GarageTech/jerkmaster/docs/build-notes.md

<p align="center">
  JerkMaster
</p>

<p align="center">
  <a href="../README.md">About</a> ·
  <a href="technical-readme.md">Technical overview</a> ·
  <a href="build-notes.md">Build notes</a> ·
  <a href="about-recipes.md">Recipes</a> ·
  <a href="installation.md">Installation</a> ·
  <a href="hardware.md">Hardware</a> ·
  <a href="wiring.md">Wiring</a> ·
  <a href="../SECURITY.md">Safety</a>
</p>

# Build Notes

This project did not start with choosing a dehydrator specifically for modification. I originally bought the VEVOR dehydrator for normal use, and only later started modifying it after running into the limitations of the factory controller.

By coincidence, this particular model turned out to be a very good platform for this type of conversion.

JerkMaster dehydrator cutaway blueprint

VEVOR sells several dehydrators in this line, differing in size, power and number of drying trays. However, they appear to share a very similar layout: a stainless steel drying chamber, rear-mounted fan and heater assembly, and a separate electronics bay located at the top of the unit.

My unit is the smallest model in the range, with 6 trays measuring approximately 20 × 28 cm. In practice, it can hold around 1.2–1.4 kg of meat sliced to about 5 mm thickness.

After briefly looking around, it is clear that many food dehydrators from other manufacturers use a similar construction: a metal box with a rear fan and heater assembly. I believe many of these machines could also be suitable for a similar conversion, as long as they provide enough internal space and a reasonable separation between the drying chamber and the electronics.

One important practical note: the body of this dehydrator is made from thin but very strong stainless steel. Working with it is not as easy as it may seem. Even simple operations such as drilling holes can become surprisingly difficult without proper tools, sharp drill bits, low speed, cutting oil and patience.

As mentioned earlier, my internal hardware build was based partly on components I already had available from previous projects. However, the architecture is flexible. You do not have to use exactly the same hardware. Any controller board supported by Klipper can be used, and you are free to choose your own host controller, SSRs, power supplies, wiring layout and mounting approach.

In other words, use what you already have — especially if, like many DIY and 3D printing enthusiasts, you have old controller boards, power supplies, connectors and other useful parts gathering dust on a shelf.

Regarding SSR heatsinks: in my build I used oversized heatsinks. This was mainly because I was building the project away from my main workshop, where I do not have access to my usual stock of parts. During early testing, the rear wall of the dehydrator became quite hot, so I decided to use large heatsinks from the beginning rather than buy and test several smaller options. It was a conservative choice intended to remove one possible thermal problem from the project.

## Electronics Bay Conversion

The factory electronics bay provided enough space for the Raspberry Pi, SKR
controller, two power supplies, SSRs, heatsinks, and mains distribution. The
photos below show the bay before the conversion and during assembly.

| Original electronics bay | Open converted bay |
|---|---|
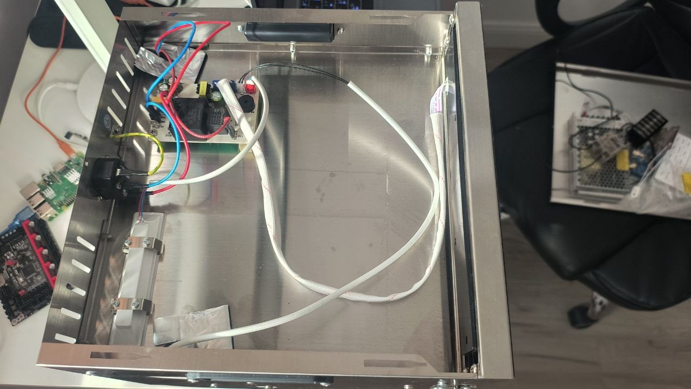
[picture p13: img/docs/build/original-electronics-bay.jpg]
Original dehydrator electronics bay
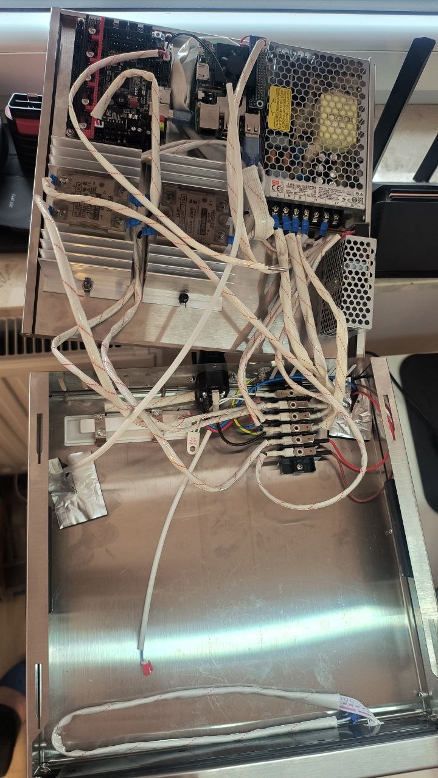
[picture p14: img/docs/build/electronics-bay-open.jpg]
Open JerkMaster electronics bay
|  |  |

The final layout mounts the main electronics to the removable upper panel. This
makes the complete assembly accessible for inspection, but it also makes cable
routing and strain relief especially important.

These are build-progress photographs taken with the appliance disconnected and
opened for inspection. Never operate the dehydrator with exposed mains wiring
or an open electronics enclosure.

| Installed electronics | Barrier terminal wiring |
|---|---|
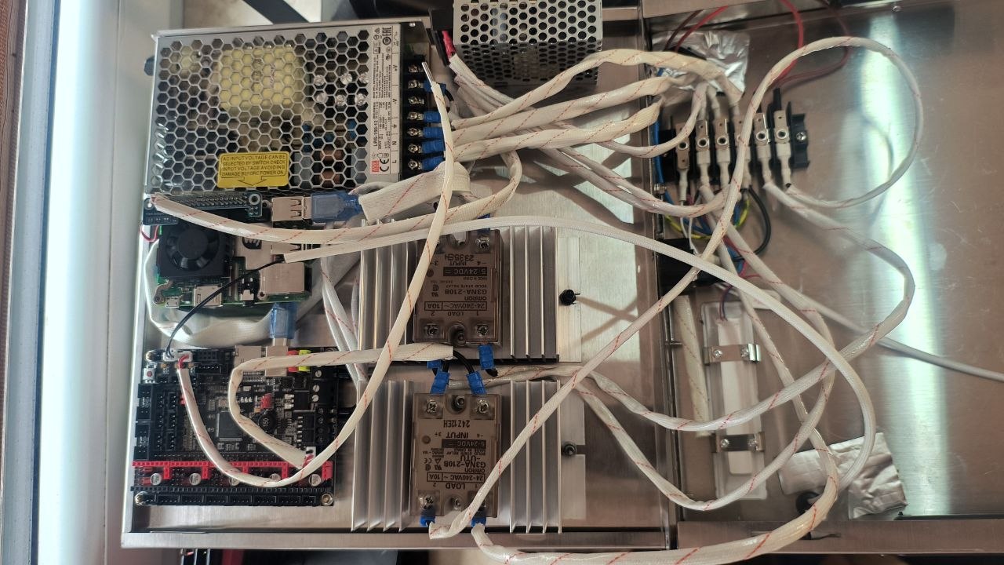
[picture p15: img/docs/build/electronics-bay-installed.jpg]
Installed JerkMaster electronics
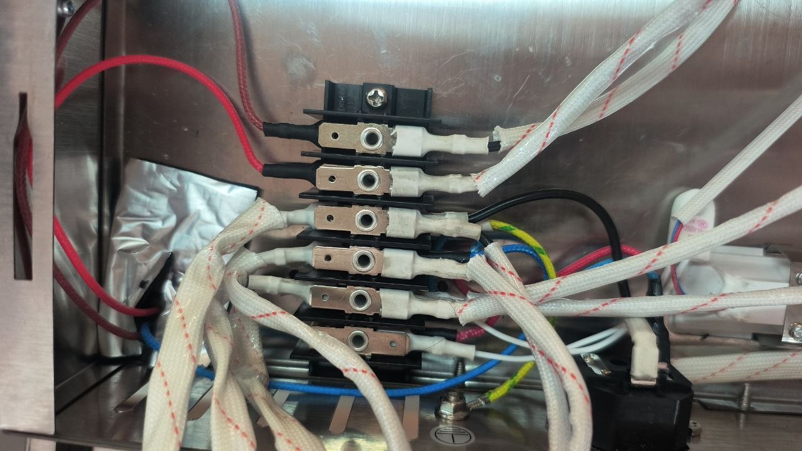
[picture p16: img/docs/build/barrier-terminal-wiring.jpg]
Barrier terminal and heat-resistant wiring
|  |  |

## Safety Warning

This project involves modifying a mains-powered household appliance with a metal enclosure and 220–240 V AC wiring.

Work carefully and responsibly.

If you do not clearly understand what you are doing, do not attempt this modification yourself. Either abandon the project or ask a qualified electrician to help with the mains wiring, grounding, fusing and safety checks.

Use proper wire, reliable terminals and heat-resistant insulation where required. Pay special attention to wiring near the heater and any high-temperature areas.

Use suitable crimp terminals and a proper crimping tool. Do not crimp electrical terminals with pliers, a vise, a hammer, or anything else that only “looks good enough”. A poor crimp may work for a while, but sooner or later the wire can loosen, pull out, touch the metal case, and create a dangerous failure.

This is not a low-voltage toy project. Treat it like real electrical equipment.

## Current Front Panel

The current front-panel architecture replaces the original controls with two
centered round status displays, two Noctua NF-A4x10 FLX electronics-bay cooling
fans on SKR FAN1/FAN3, a power/wake button, an action/safe-shutdown button, and
Raspberry Pi sound feedback.

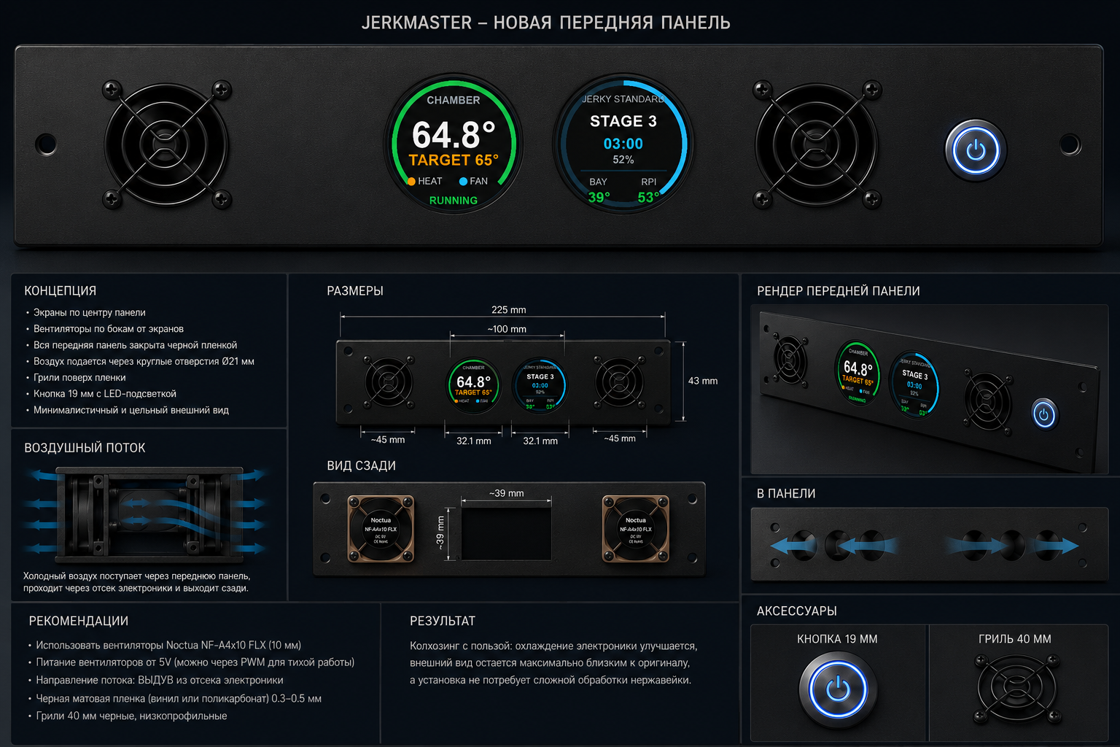
[picture p17: img/docs/illustrations/front-panel-concept.png]
JerkMaster front-panel concept


The original stainless panel was stripped and prepared for the new layout. The
rectangular opening and circular cutouts are covered by the new front-panel
insert.

| Stripped original frame | Prepared front-panel cutouts |
|---|---|
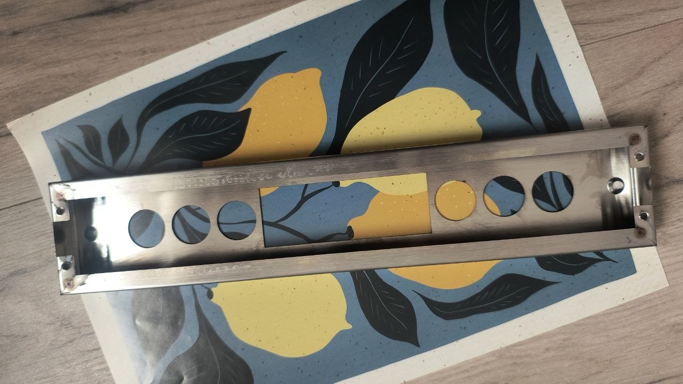
[picture p18: img/docs/build/front-panel-frame.jpg]
Stripped original control-panel frame
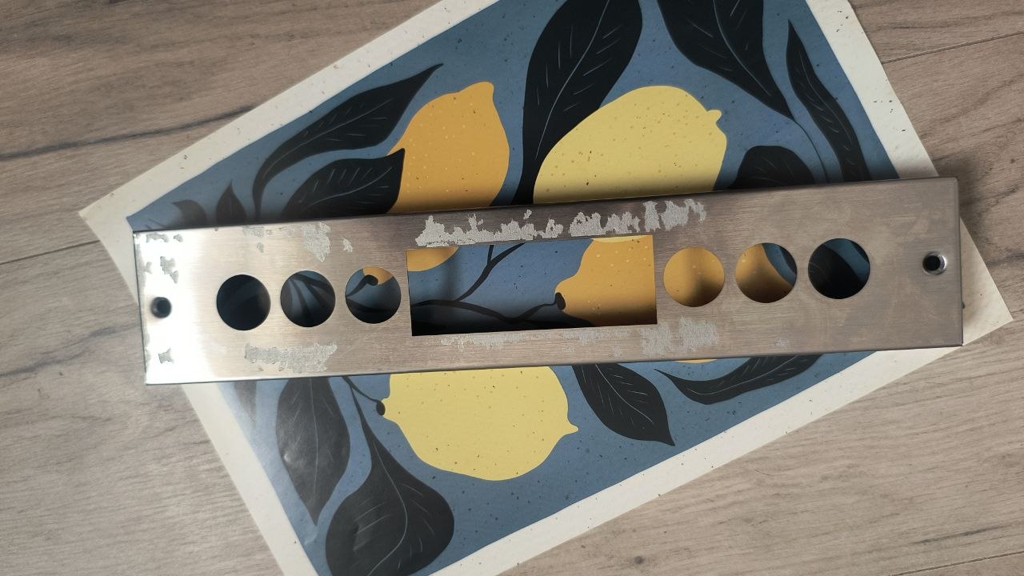
[picture p19: img/docs/build/front-panel-cutouts.jpg]
Prepared front-panel cutouts
|  |  |

The display board was first assembled and tested on the bench before being
integrated into the front-panel wiring.

| Display board assembly | Live dual-display test |
|---|---|
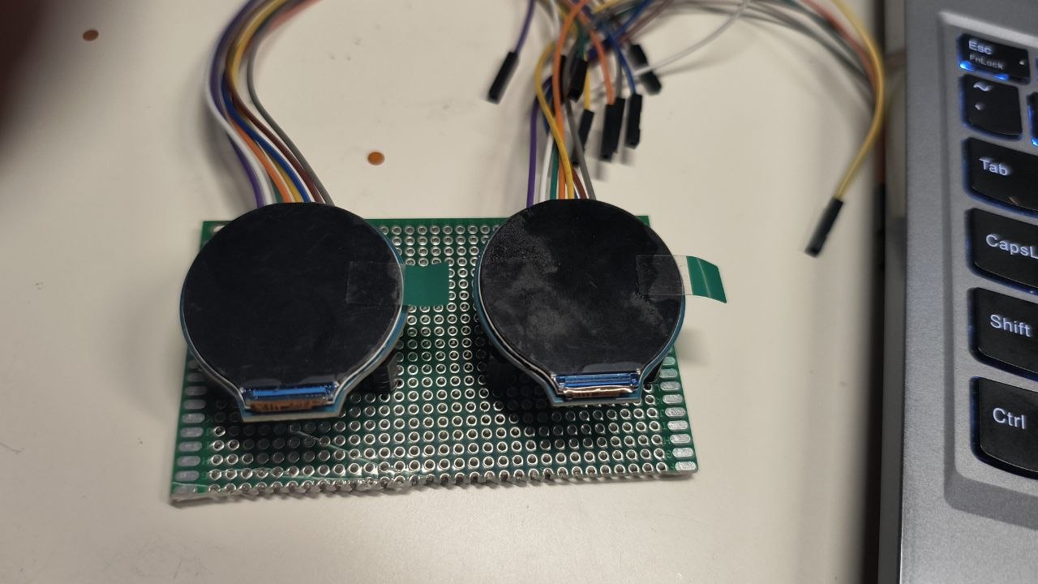
[picture p20: img/docs/build/display-bench-assembly.jpg]
Dual GC9A01 display board on the bench
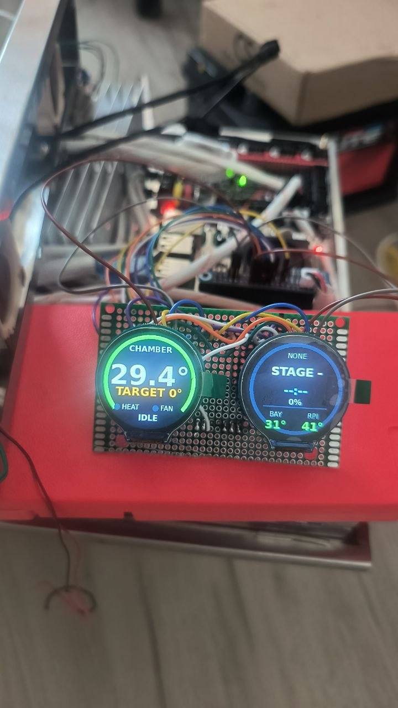
[picture p21: img/docs/build/status-displays-live-test.jpg]
Live JerkMaster dual-display test
|  |  |

The two fans sit on either side of the displays and provide a direct airflow path
through the electronics bay. The current build uses 2 pcs Noctua NF-A4x10 FLX
connected to SKR FAN1 and FAN3 for electronics-bay cooling.

The power/wake momentary button is used to restart electronics through a BTT
Power Shutdown Relay V1.2 after relay shutdown. Its switch contacts and LED are
electrically separate:

- the momentary switch contacts connect only to the relay module's button input;
- the relay module receives mains input continuously and switches the downstream
  electronics supply;
- the power button LED is driven from 12 V through the SKR BED MOSFET output;
- the action button LED is driven from 12 V through the SKR HE1 MOSFET output;
- the action button contacts are handled by SKR Y-STOP / `P1.28` with an
  internal pull-up and a GND return;
- the normally closed door microswitch is handled by SKR Z-STOP / `P1.29` with
  an internal pull-up and a GND return.

The buttons are normal power and interface controls, not emergency stops. They
must not replace the physical E-stop, independent thermal fuse, breaker,
protective earth, or a correctly rated safety contactor where one is required.

## Real-World Use

The converted dehydrator is already used for regular jerky batches while the
hardware and interface continue to evolve.

| Loaded dehydrator and finished tray | Finished jerky |
|---|---|
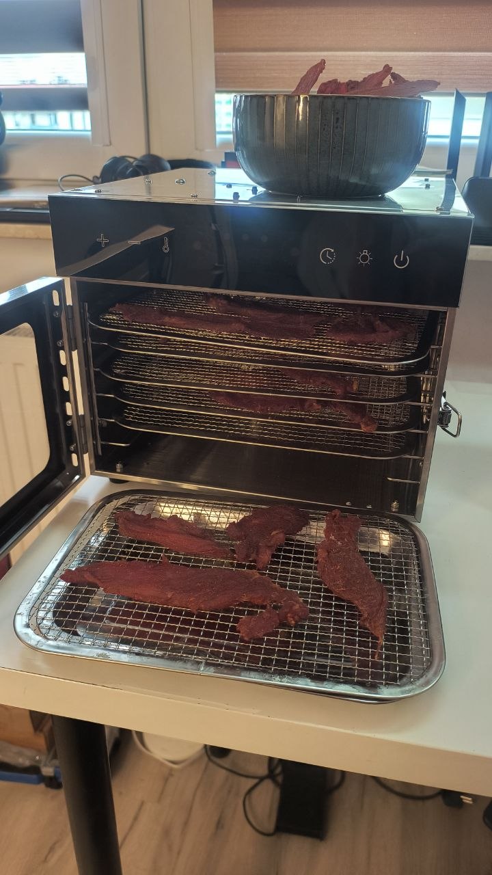
[picture p22: img/docs/build/dehydrator-loaded-and-unloaded.jpg]
Loaded dehydrator with a finished tray
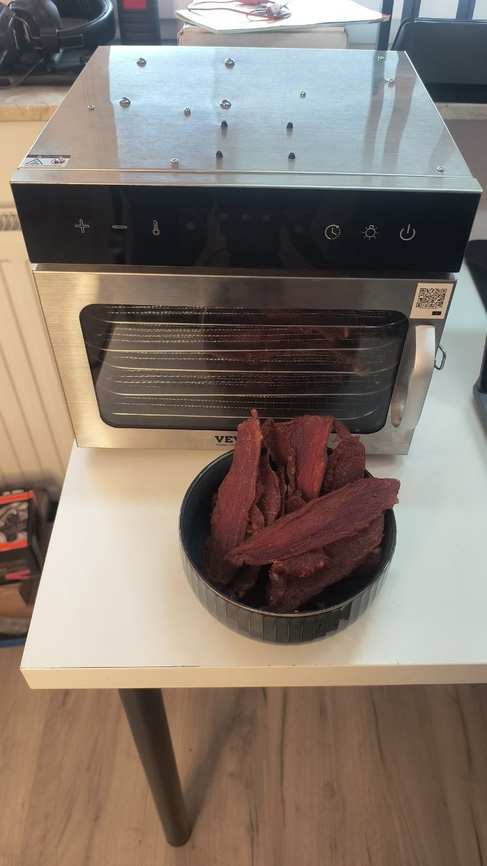
[picture p23: img/docs/build/finished-jerky.jpg]
Finished homemade jerky
|  |  |

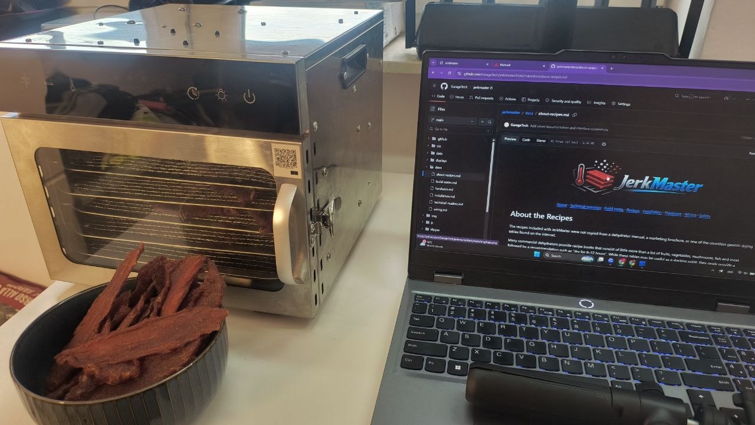
[picture p24: img/docs/build/jerkmaster-and-project-docs.jpg]
JerkMaster dehydrator beside the project documentation
