GarageTech/jerkmaster/making-jerky.html

JerkMaster

# Making Jerky

A practical workspace for documenting your complete jerky process.

01

## Select and prepare meat

Use lean meat, remove visible fat and chill it before slicing.

02

## Slice consistently

Keep slices even so every tray dries at a similar rate.

03

## Marinate

Measure salt carefully, mix thoroughly and marinate refrigerated.

04

## Dry and verify

Arrange without overlap, run the selected profile and verify texture and weight loss.

Making jerky with JerkMaster

See the complete practical jerky-making process.

JerkMaster v0.2.1 GarageTech / JerkMaster (https://github.com/GarageTech/jerkmaster)
