GarageTech/jerkmaster/CHANGELOG.md

# Changelog

This file records the project history in chronological order. New functional,
hardware, interface, documentation, and safety changes must be added here as
part of the same commit. Commit hashes are intentionally omitted so a future
security-related history rewrite does not leave links to superseded commits.

## 2026-06-10

### Initial JerkMaster release

- Added the browser dashboard for Klipper and Moonraker dehydrator control.
- Added multi-stage and custom drying modes.
- Added recipe, ingredient, and drying-profile editors.
- Added recipe scaling, salinity calculations, and spice-mix dosage calculations.
- Added English, Russian, and Ukrainian translations.
- Added live telemetry, temperature history, diagnostics, and emergency-stop integration.
- Added initial Klipper, Moonraker, macro, G-code, hardware, installation, and wiring documentation.
- Added contribution, security, release, issue, and community documentation.

## 2026-06-13

### Tune dryer hardware configuration

- Tuned the generic heater PID configuration from real dryer tests.
- Updated controller pin mappings and hardware documentation.

### Run JerkMaster on Raspberry Pi

- Added Raspberry Pi installation tooling and deployment instructions.
- Updated Moonraker configuration for the Raspberry-hosted interface.

### Restore active drying session in dashboard

- Persisted the active drying session so dashboard navigation and browser reopening no longer reset its displayed state.
- Improved Moonraker drying-state handling.

### Make project story the main README

- Replaced the main README with the JerkMaster project story.
- Moved the original technical content to `docs/technical-readme.md`.

### Add dehydrator build notes

- Added build notes covering the VEVOR dehydrator, reusable hardware, heatsinks, the original control panel, and mains safety.

### Merge pull request #1

- Merged the initial Raspberry runtime, drying-state restoration, and documentation work.

### Add recipe background and unified docs navigation

- Added recipe background and attribution documentation.
- Added consistent navigation links across the project documentation.

### Add chamber light control

- Added chamber-light control to Klipper, Moonraker, and the web interface.
- Added chamber-light wiring and installation documentation.

### Correct chamber light connector to HE1

- Corrected the chamber-light output mapping and documentation from the earlier connector assignment to HE1.

### Add visual documentation and interface screenshots

- Added screenshots for the dashboard, ingredients, recipes, profiles, and jerky-making pages.
- Added dehydrator and terminal wiring illustrations to the documentation.

### Merge pull request #2

- Merged recipe documentation, chamber-light control, and visual documentation work.

### Update terminal illustration with female Faston connectors

- Updated the terminal illustration to include female Faston connectors.

### Fix dashboard screenshot and surface dehydrator sketch

- Replaced the broken dashboard screenshot.
- Added a clearly visible dehydrator blueprint illustration.

### Merge pull request #3

- Merged the corrected dashboard screenshot and updated hardware illustrations.

### Correct insulated Faston terminal illustration

- Corrected the insulated Faston terminal variants in the wiring illustration.

### Expand terminal and fastener blueprint documentation

- Expanded the terminal blueprint.
- Added a separate fastener and PCB-standoff blueprint.

### Separate crimper and terminal blueprint sheets

- Moved the Pro'sKit crimper to a dedicated blueprint sheet.
- Updated hardware documentation and simplified the terminal sheet.

### Merge pull request #4

- Merged the final terminal, fastener, and crimper illustration updates.

### Restore active drying state from Klipper

- Made Klipper the authoritative source for restoring an active drying process.
- Improved macro state reporting and dashboard recovery after reconnecting.

### Allow Raspberry hostnames in Moonraker CORS

- Allowed Raspberry Pi hostnames in Moonraker CORS configuration.
- Documented the hostname access configuration.

### Preserve active drying timer across navigation

- Preserved the drying timer and progress calculation when navigating away from and back to the dashboard.

### Add animated dual status displays

- Added support for two round GC9A01 status displays.
- Added large status layouts, periodic JerkMaster branding, and animated robot eyes.
- Added display installation and wiring documentation.

### Add post-drying cooling stage

- Extended the third standard drying stage to 210 minutes.
- Added a final fan-only cooling stage that runs until the chamber reaches 30°C.
- Updated profiles, macros, displays, calculations, editors, and translations for temperature-based stages.

### Refine dashboard controls and chart layout

- Added manual fan control and compact chamber-light control.
- Moved Moonraker status into the controller section.
- Removed the normal-work diagnostic badge so only actual errors are shown.
- Changed the chart to a taller, approximately 30-second view.

## 2026-06-14

### Simplify active profile display

- Removed the active-profile frame and background.
- Displayed the active profile name as blue text.

### Improve temperature chart and equipment status

- Changed the chart to always display chamber, Raspberry Pi, and electronics-bay temperatures.
- Removed the target-temperature line and displayed current and target values beside the chart legend.
- Formatted spice-mix and marinade quantities with exactly one decimal place.
- Spread the equipment status row across the available width and added text to fan and light controls.

### Restore active profile label

- Restored the translated `Active profile` label while keeping the profile name as unframed blue text.

## Unreleased

### Changed

- Replaced the HE1 chamber light output with an 8x WS2812B NeoPixel line on `P1.24`, controlled through `SET_CHAMBER_LIGHT`.
- Added `PS_ON` on `P2.0` for the BTT Relay V1.2 shutdown module and scheduled automatic power-off ten minutes after completed drying.
- Added a periodic active-drying display scene with an animated filling beer glass, bubbles, progress percentage, and remaining time.
- Added a Raspberry Pi GPIO17 button that triggers a two-screen blackjack animation only during active drying.
- Expanded the GPIO17 blackjack scene into a playable one-button game with player and dealer hands, hit actions, timed stand, dealer draw rules, and round results.
- Added a mobile version of the web interface with bottom icon navigation and dashboard workflow tabs for meat/marinade setup, spice mix, drying start, and time monitoring.
- Changed custom drying so the timed stage cools the chamber to 30 C before `DRYER_COMPLETE` schedules the ten-minute automatic power-off delay.
- Added `0.1.0-alpha` current-status and known-issues sections to the main README.
- Expanded `.gitignore` for Wi-Fi credentials, Moonraker secrets, API keys, SSH keys, certificates, personal configs, user data, and backups.
- Replaced the reference-build MCU serial and exact local IP example with public-safe placeholders.
- Removed historical commit-hash links before the public repository history scrub.
- Moved user-created and edited ingredients, recipes, and profiles from browser local storage to persistent Raspberry Pi user-data files shared by every browser.
- Added an atomic Raspberry user-data API and documented backup of `/var/lib/jerkmaster/user-data/`; existing browser-local edits are intentionally not migrated.
- Added a credential-free Raspberry Pi updater that installs the public `main` archive without Git or a GitHub account.
- Audited all interface translations and CSS, and removed obsolete diagnostic-status styles.
- Fixed mobile navigation and ingredient-toolbar overflow found during the CSS audit.
- Refreshed the About-page dashboard screenshot.
- Added live heater and fan PWM percentages to the controller status row.
- Placed the `Active profile` label above the active profile name.
- Changed the temperature chart to a minute-based time axis with selectable 5, 15, 30, and 60 minute ranges.
- Made Klipper `DRYER_STATE` the only authoritative source for real drying-state restoration.
- Added the active recipe and final result to `DRYER_STATE` so browser reopening restores the exact running process without browser-side guesses.
- Synchronized the dashboard timer to Klipper elapsed time on every telemetry update.
- Made the deployable web service Raspberry-only and removed alternate Moonraker URL support.
- Replaced the generic Python static server with a Raspberry service that disables browser caching and exposes `/health`.
- Localized ingredient amount numbers and units for English, Russian, and Ukrainian.
- Finalized the split Raspberry Pi/SKR hardware architecture with SKR-owned button LEDs, concrete door/action inputs, BTT Relay power control, dual GC9A01 display wiring from the display runtime, and MAX98357A sounds used by the display service.
- Bumped the project and visible interface version to `0.2.1-alpha` for the mobile workflow and custom-cooling release.
- Added display bench-assembly and live dual-display test photographs to the build notes gallery.
- Implemented Klipper button LED blink/pulse effects, door-open chamber-light and drying-pause behavior, and action-button long-press display events.
- Corrected the current hardware documentation to describe the chamber light as an 8x WS2812B line, confirm 32 MHz SPI and pin 20 GND for the round displays, keep the VEVOR dehydrator section limited to original hardware, and record the Noctua NF-A4x10 FLX electronics-bay fans on SKR FAN1/FAN3.
- Corrected the GC9A01 left/right SPI and backlight mapping, added shutdown-pending display and telemetry handling, changed the SKR action-button long press to request staged safe shutdown, and added the Raspberry systemd relay power-cut hook.
- Added explicit non-blocking sound events for startup, action, warning, completion, and shutdown using the existing MAX98357A `hw:1,0` stereo playback path.
- Added a dual-display red/green wiring test script and documented the current display, audio, door, button LED, BTT Relay, and safe-shutdown verification commands.
- Moved the user/action button to Raspberry Pi GPIO17 with internal pull-up handling, kept BTT Relay RESET as wake/restart only, and moved the NC door switch to SKR Z-STOP / `P1.29`.
- Removed SKR action-button short/long-press assumptions while keeping SKR ownership of the door switch, button LED MOSFETs, heater/fan outputs, and `PS_ON`.
- Moved the user/action button input to SKR Y-STOP / `P1.28` with a GND return, kept the NC door switch on SKR Z-STOP / `P1.29` with a GND return, and updated the display service to consume the Klipper button state.
- Inverted the SKR action-button and door-switch inputs so GND-closed wiring reads as active only when the button is pressed or the NC door switch is closed.
- Replaced the long `speaker-test` installation/audio check with a short installed JerkMaster sound playback.
- Made Raspberry/Python the single owner of Linux shutdown, changed the relay cut service to run only for poweroff/halt and never reboot, increased the Klipper relay fallback to 60 seconds, and limited the beer animation to active drying or demo mode.
- Added a Raspberry bootstrap installer that detects the SKR MCU, generates Klipper configuration from templates, merges Moonraker settings with backups, installs services, and offers display/audio tests.
- Replaced checked-in machine-specific `printer.cfg` and `moonraker.conf` examples with installable templates and a Moonraker merge patch.
- Added the final hardware checklist and simplified the README, installation guide, and technical quick start around the bootstrap-driven Raspberry install path.

### Fixed

- Moved lower status-display labels and temperatures fully inside the round screens.
- Prevented completed or stopped drying processes from being restored from stale browser storage.
- Fixed Russian `г` and Russian number formatting appearing in the English ingredient tables.
- Added the missing translation for the calculated-salinity label.

### Removed

- Removed browser-local active drying state, the local-computer development server, and temporary preview files.
- Removed duplicate chamber-light controls from secondary pages and their separate Moonraker client logic.
- Removed unused Klipper state variables, `save_variables`, and ambiguous `START`, `STOP`, and `ESTOP` aliases.

### Documentation

- Replaced the small About video link with a prominent custom video preview.
- Added the project video to About and embedded the practical process video in Make Jerky using lightweight YouTube links.
- Completed the public-release secret/history audit and published the `v0.1.0-alpha` tag.
- Added real build photographs covering the electronics-bay conversion, terminal wiring, front-panel fabrication, and finished jerky.
- Replaced the obsolete original-control-panel description with the dual-display, dual-fan, momentary-button front-panel concept.
- Documented BTT Power Shutdown Relay V1.2 power domains and added the blue button LED to the reference pin mapping.
- Selected BED/P2.5 for the blue button LED and kept unused button LED channels disconnected.
- Added rendered previews of the dual round status-display states.
- Replaced password-prone `git pull` update instructions with the public archive updater.
- Reconstructed the complete project changelog in chronological commit order with links to all existing commits.
- Added contributor and agent rules requiring `CHANGELOG.md` updates with future project changes.
- Reworked installation and technical documentation around a single Raspberry Pi deployment.
