GarageTech/jerkmaster/(commit log)

2026-06-10 Initial JerkMaster release
    [hardware.cfg, macros.cfg, printer.cfg]
2026-06-12 Tune dryer hardware configuration
    [hardware.cfg]
2026-06-12 Run JerkMaster on Raspberry Pi
2026-06-13 Add chamber light control
    [hardware.cfg]
2026-06-13 Correct chamber light connector to HE1
    [hardware.cfg]
2026-06-13 Update terminal illustration with female Faston connectors
2026-06-13 Restore active drying state from Klipper
    [macros.cfg]
2026-06-13 Allow Raspberry hostnames in Moonraker CORS
2026-06-13 Preserve active drying timer across navigation
2026-06-13 Add post-drying cooling stage
    [macros.cfg]
2026-06-13 Improve temperature chart and equipment status
2026-06-13 Make Raspberry and Klipper state authoritative
    [macros.cfg, printer.cfg]
2026-06-14 Show SSR PWM power percentages
2026-06-14 Store user catalogs on Raspberry Pi
2026-06-14 Document new front panel power design
2026-06-14 Clarify final front panel wiring
2026-06-14 Simplify front panel pin mapping
2026-06-21 Switch chamber light to NeoPixel and add relay shutdown
    [hardware.cfg, macros.cfg]
2026-06-30 Finalize Raspberry and SKR hardware split
    [hardware.cfg, macros.cfg]
2026-06-30 Add door pause and display button events
    [macros.cfg]
2026-06-30 Correct current hardware wiring docs
    [hardware.cfg, macros.cfg]
2026-06-30 Align hardware control with prototype
    [macros.cfg]
2026-06-30 Move user button to Raspberry
    [hardware.cfg, macros.cfg]
2026-07-01 Prevent relay cut during reboot
    [macros.cfg]
2026-07-01 Polish Raspberry bootstrap install
2026-07-15 Improve mobile workflow and custom cooling
    [hardware.cfg, macros.cfg]
2026-07-19 Move action button to SKR Y-STOP
    [hardware.cfg, macros.cfg]
2026-07-19 Fix grounded SKR input polarity
    [hardware.cfg]
